ChaoPhone/Box-esp32/docs/戒指打印模型/10/10按键.STEP

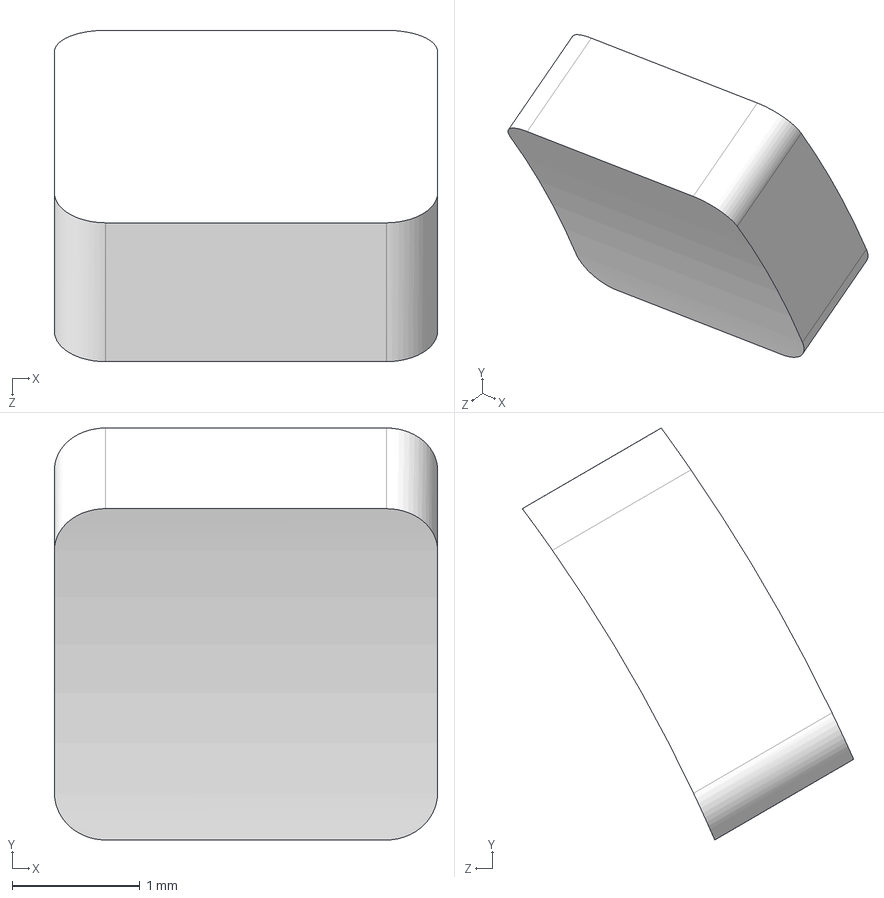
[picture p1: CAD file, 2026-07-25]
docs/戒指打印模型/10/10按键.STEP
3.00 x 3.23 x 2.59 mm
