ChaoPhone/Box-esp32/docs/戒指打印模型/11/11外圈.STEP

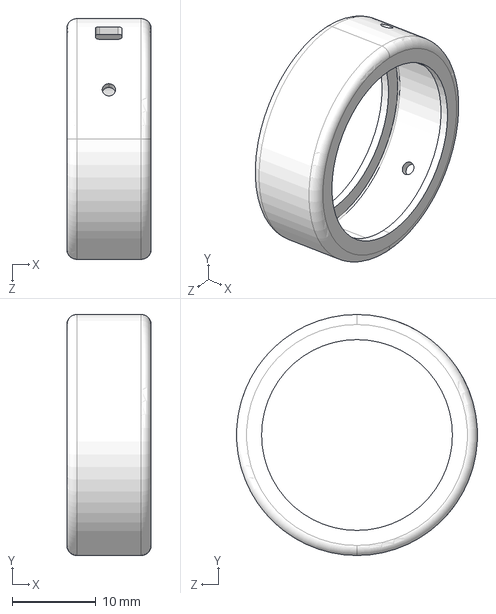
[picture p2: CAD file, 2026-07-25]
docs/戒指打印模型/11/11外圈.STEP
10.1 x 28.8 x 28.8 mm
