ChaoPhone/Box-esp32/docs/戒指打印模型/7/7外圈.STEP

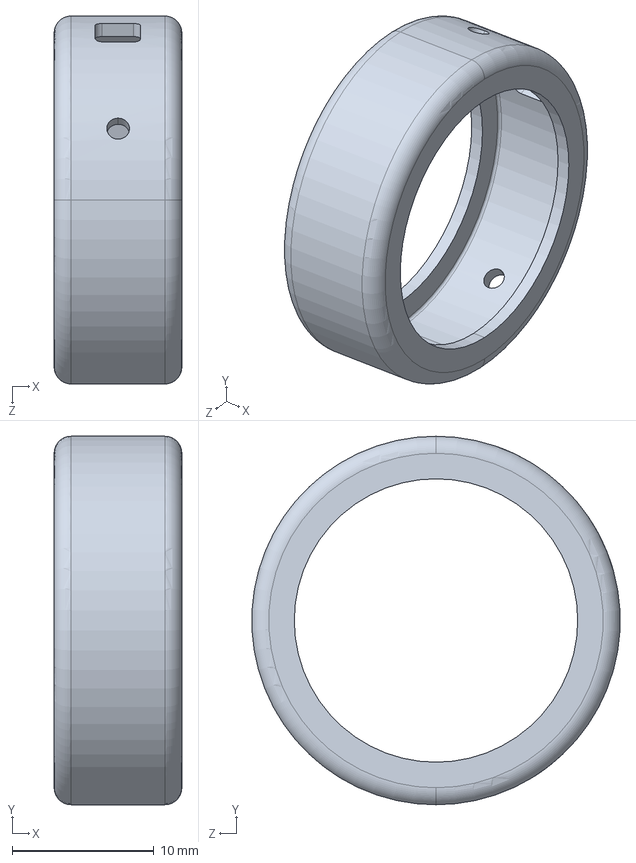
[picture p3: CAD file, 2026-07-25]
docs/戒指打印模型/7/7外圈.STEP
9.00 x 26.0 x 25.9 mm
