ChaoPhone/Box-esp32/docs/戒指打印模型/9/9外圈.STEP

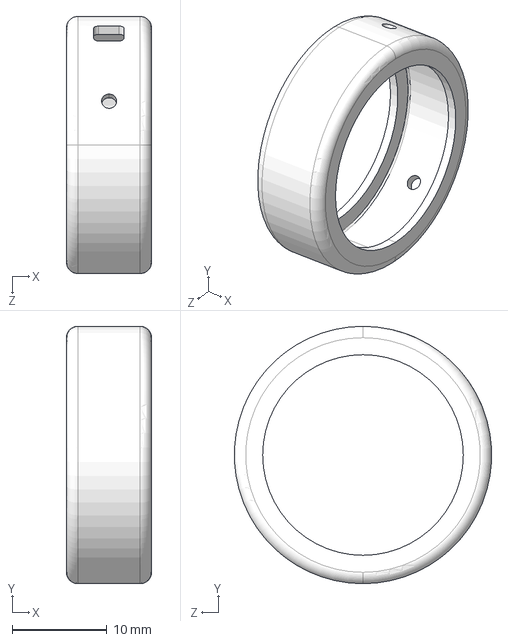
[picture p4: CAD file, 2026-07-25]
docs/戒指打印模型/9/9外圈.STEP
9.00 x 27.2 x 27.2 mm
