ChaoPhone/Box-esp32/docs/戒指打印模型/10/10外壳.STEP

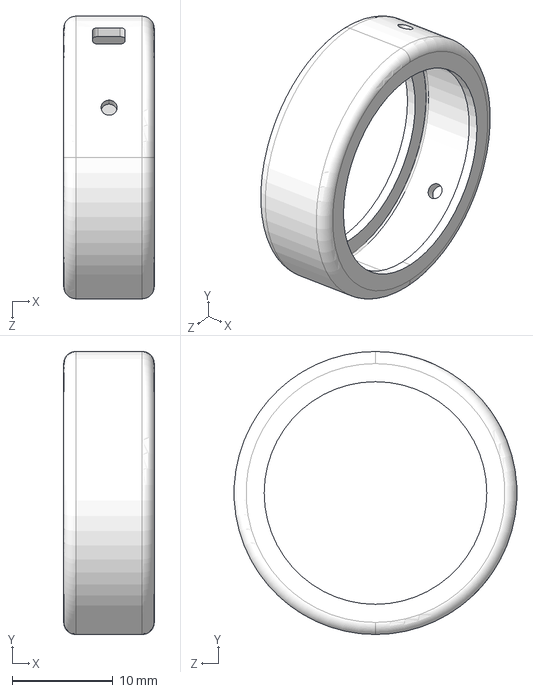
[picture p5: CAD file, 2026-07-25]
docs/戒指打印模型/10/10外壳.STEP
9.00 x 28.1 x 28.1 mm
