ChaoPhone/Box-esp32/docs/戒指打印模型/11/11按键.STEP

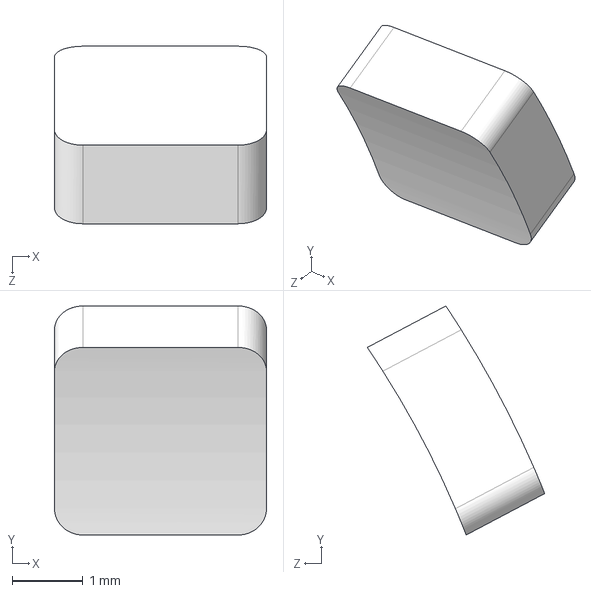
[picture p6: CAD file, 2026-07-25]
docs/戒指打印模型/11/11按键.STEP
3.00 x 3.24 x 2.51 mm
