ChaoPhone/Box-esp32/docs/戒指打印模型/7/7按键.STEP

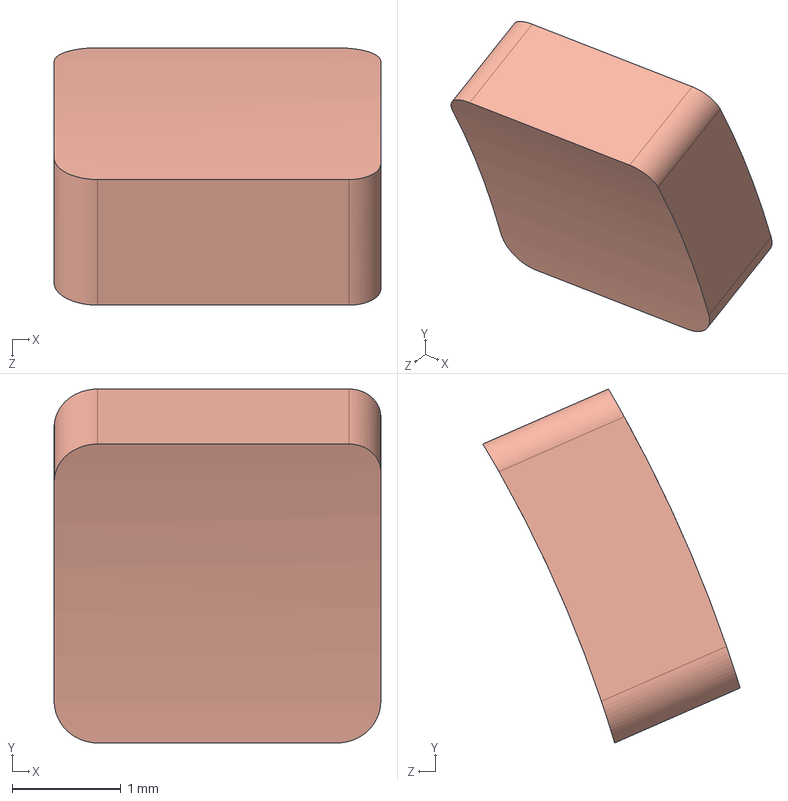
[picture p7: CAD file, 2026-07-25]
docs/戒指打印模型/7/7按键.STEP
3.00 x 3.25 x 2.36 mm
