ChaoPhone/Box-esp32/(list of files, cad)

Other CAD files:
docs/戒指打印模型/9/9按键.STEP
