ChaoPhone/Box-esp32/(commit log)

2026-07-25 init: B-Box ESP32 固件 — 推动/倾斜/抬举检测 + 协议文档 + 桥接工具
    [10外壳.STEP, 10按键.STEP, 11外圈.STEP, 11按键.STEP, 7外圈.STEP, 7按键.STEP, 9外圈.STEP, 9按键.STEP]
2026-07-25 feat: 震动电机 GPIO1 PWM 驱动 + LIFT_UP 自动震动 + 协议文档更新
2026-07-25 feat: AB 双板 ESP-NOW 通信 — A板桥接PC, B板IMU检测+电机
2026-07-25 fix: 交换AB角色 — A板箱子(IMU), B板桥接(USB)
    [main_A_win.cpp, main_B_esp.cpp]
2026-07-25 rename: main_a_box(箱子) + main_b_win(桥接), 统一命名
2026-07-25 feat: TILTS 持续倾斜状态(20Hz) — 兼容原有 TILT_* 离散EVT + 协议更新
2026-07-25 refactor: tilt 从离散EVT改为持续状态TILTS — MOVE/LIFT_UP保持EVT不变
2026-07-25 feat: HAPTIC WIN三长震+WALL短震(255满电平) + 摇动检测TILT_TOGGLE(3次≥30°切换倾斜模式)
    - HAPTIC 'win' 模式：三次300ms长震(间隔100ms)，满电平255
    - HAPTIC 'short'/'long' 默认强度改为255
    - 摇动检测：倾角≥30°计一次，回落<15°武装，3次/3秒→EVT TILT_TOGGLE
    - 每次摇动即时短震反馈(255/40ms)
    - 电机模式队列(motorQueuePattern/motorTick)支持多脉冲
    - 固件版本 0.9.1-haptic-tilt
    [main_a_box.cpp]
2026-07-25 feat: 绕Z轴旋转3圈→Undo + B板桥接转发UNDO
2026-07-25 feat(web): TILTS解析+EVT自动ACK+UNKNOWN过滤+B板脏帧调试
2026-07-25 refactor: 去掉不稳定检测(摇动/旋转3圈) → 换翻面>80°→UNDO
2026-07-25 fix: UNDO改为emitEvent(标准EVT)+翻面300ms防误触+弹珠模式倾斜保持2s进入
2026-07-25 docs: 协议v0.9.0-flip — UNDO/RESET/MARBLE/TILTS取代TILT_*
    [main_a_box.cpp]
